vedantpathak2020-hue/Pascal/README.md

# Pascal
A repo for pascal (mazesolver v3)
