vedantpathak2020-hue/Pascal/pascalV0.1.pdf

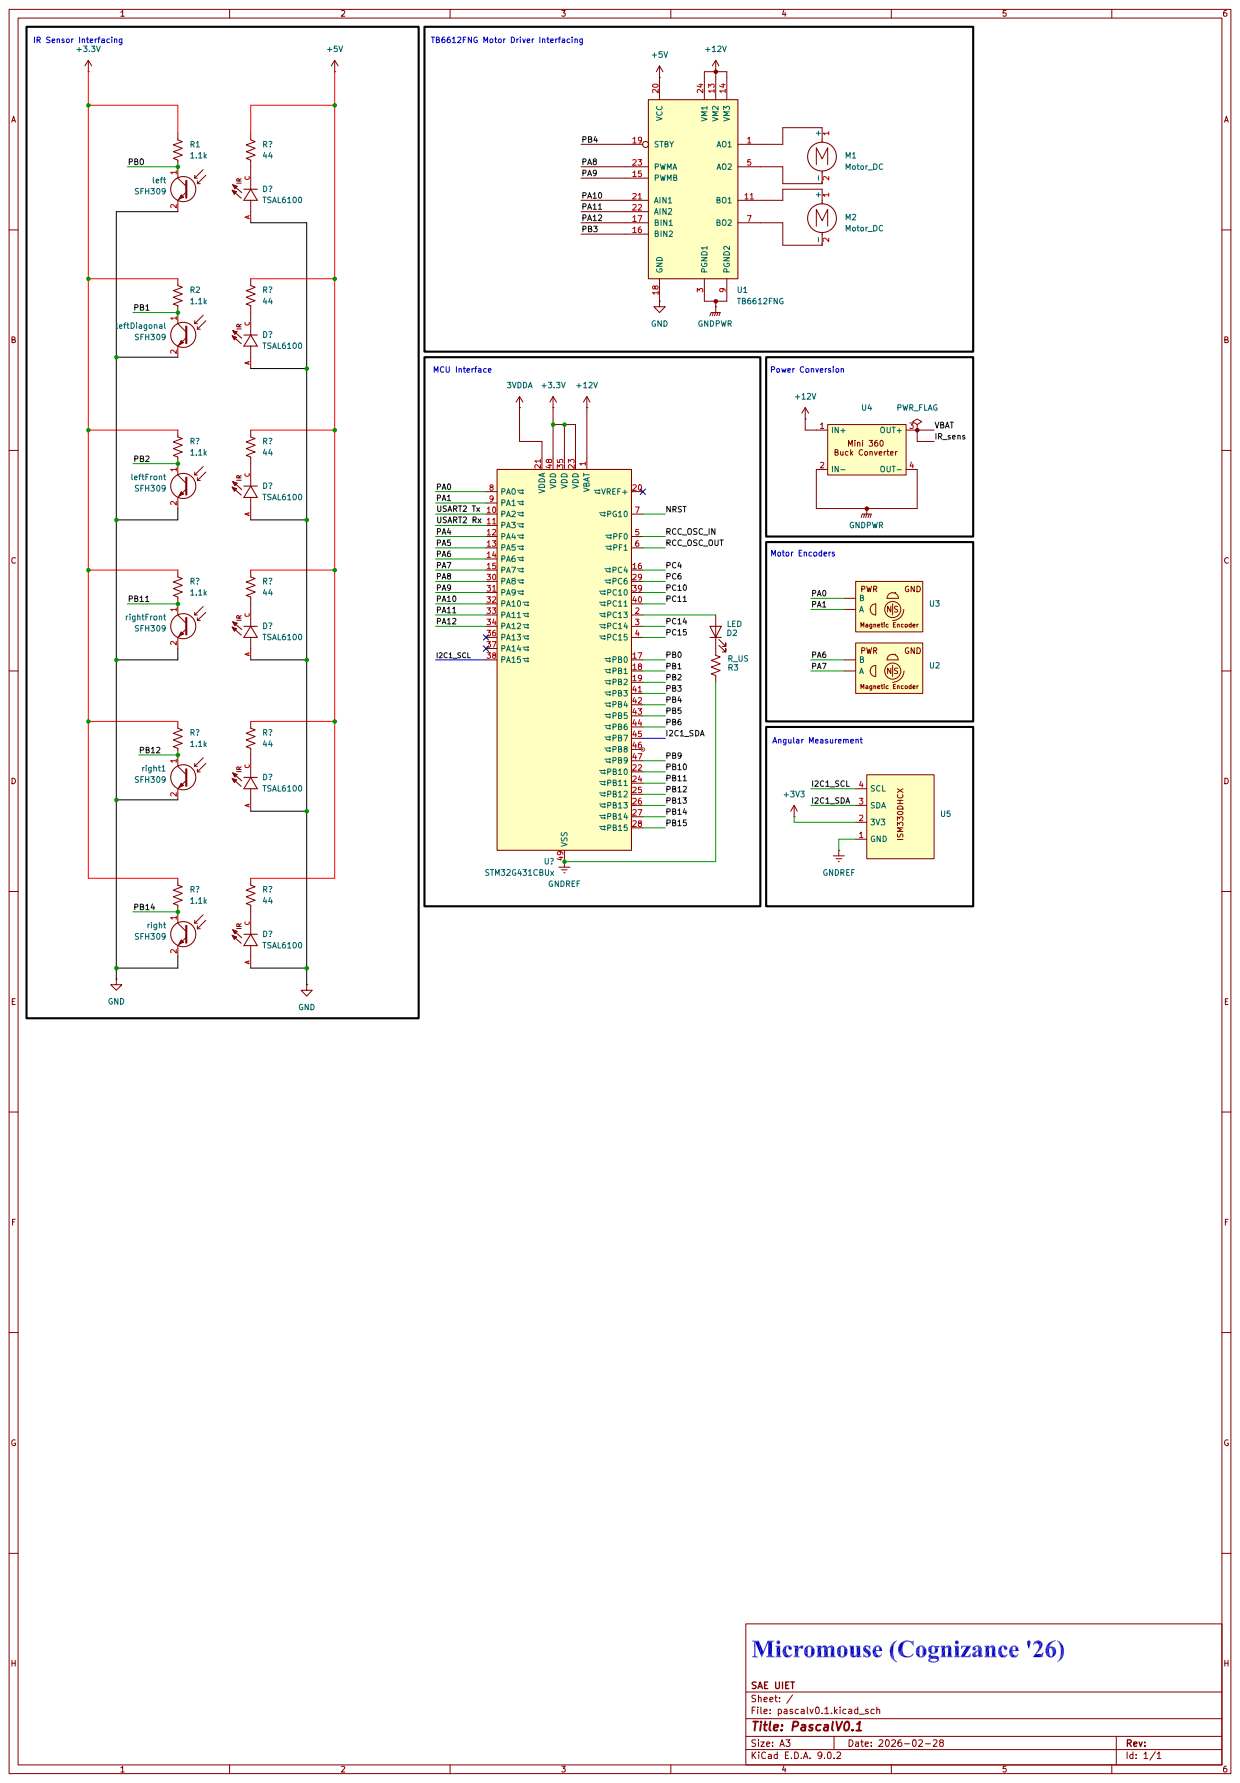
[picture p5: page 1]
