vedantpathak2020-hue/Pascal/pascalV0.1/Core/Src/main.c

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
/* Includes ------------------------------------------------------------------*/
#include "main.h"

/* USER CODE BEGIN Includes */

#include <stdio.h>
#include <stdlib.h>
#include <stdbool.h>
#include <string.h>

/* USER CODE END Includes */

/* USER CODE BEGIN PTD */
ADC_HandleTypeDef hadc1;
/* USER CODE END PTD */

/* USER CODE BEGIN PD */
uint16_t adc_pb0;
uint16_t adc_pb1;
uint16_t adc_pa4;
uint16_t adc_pb11;
uint16_t adc_pb12;
uint16_t adc_pb14;
uint16_t min =0;
uint16_t max =4096;
char buffer[140];

/* USER CODE END PD */

ADC_HandleTypeDef hadc1;

I2C_HandleTypeDef hi2c1;

TIM_HandleTypeDef htim1;
TIM_HandleTypeDef htim2;
TIM_HandleTypeDef htim3;
TIM_HandleTypeDef htim6;

UART_HandleTypeDef huart2;

void SystemClock_Config(void);
static void MX_GPIO_Init(void);
static void MX_ADC1_Init(void);
static void MX_I2C1_Init(void);
static void MX_TIM1_Init(void);
static void MX_TIM2_Init(void);
static void MX_TIM3_Init(void);
static void MX_USART2_UART_Init(void);
static void MX_TIM6_Init(void);
/* USER CODE BEGIN PFP */
uint16_t read_adc1_channel(uint32_t channel);
uint16_t read_adc2_channel(uint32_t channel);
/* USER CODE END PFP */

/**
  * @brief  The application entry point.
  * @retval int
  */
int main(void)
{

  /* MCU Configuration--------------------------------------------------------*/

  /* Reset of all peripherals, Initializes the Flash interface and the Systick. */
  HAL_Init();

  /* Configure the system clock */
  SystemClock_Config();

  /* Initialize all configured peripherals */
  MX_GPIO_Init();
  MX_ADC1_Init();
  MX_I2C1_Init();
  MX_TIM1_Init();
  MX_TIM2_Init();
  MX_TIM3_Init();
  MX_USART2_UART_Init();
  MX_TIM6_Init();
  /* Infinite loop */
  /* USER CODE BEGIN WHILE */
  while (1)
  {

	  adc_pb0  = read_adc1_channel(ADC_CHANNEL_15);
	  adc_pb1  = read_adc1_channel(ADC_CHANNEL_12);
	  adc_pa4  = read_adc2_channel(ADC_CHANNEL_17);
	  adc_pb11 = read_adc1_channel(ADC_CHANNEL_14);
	  adc_pb12 = read_adc1_channel(ADC_CHANNEL_11);
	  adc_pb14 = read_adc1_channel(ADC_CHANNEL_5);

	  sprintf(buffer,
	          "min:%4u PB0:%4u PB1:%4u PB2:%4u PB11:%4u PB12:%4u PB14:%4u max:%4u\r\n",
			  min,
	          adc_pb0,
	          adc_pb1,
	          adc_pa4,
	          adc_pb11,
	          adc_pb12,
	          adc_pb14,
			  max);

	  HAL_UART_Transmit(&huart2,
	                    (uint8_t*)buffer,
	                    strlen(buffer),
	                    HAL_MAX_DELAY);

	  HAL_Delay(10);
    /* USER CODE END WHILE */

    /* USER CODE BEGIN 3 */
  }
  /* USER CODE END 3 */
}

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
/* USER CODE BEGIN 4 */
int __io_putchar(int ch)
{
    HAL_UART_Transmit(&huart2, (uint8_t *)&ch, 1, HAL_MAX_DELAY);
    return ch;
}
/* USER CODE END 4 */
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
