vedantpathak2020-hue/Pascal/pascalV0.1/pascalV0.1.ioc

Mcu.UserName=STM32G431CBUx
PA0.GPIO_Label=Encoder1_1
PA0.Signal=S_TIM2_CH1
PA1.GPIO_Label=Encoder1_2
PA1.Signal=S_TIM2_CH2
PA10.GPIO_Label=IN1
PA10.Signal=GPIO_Output
PA11.GPIO_Label=IN2
PA11.Signal=GPIO_Output
PA12.GPIO_Label=IN3
PA12.Signal=GPIO_Output
PA13.Signal=SYS_JTMS-SWDIO
PA14.Signal=SYS_JTCK-SWCLK
PA15.Signal=I2C1_SCL
PA2.Signal=USART2_TX
PA3.GPIO_Label=LeftForwardIR
PA3.Signal=ADC1_IN4
PA6.GPIO_Label=Encoder2_1
PA6.Signal=S_TIM3_CH1
PA7.GPIO_Label=Encoder2_2
PA7.Signal=S_TIM3_CH2
PA8.GPIO_Label=PWMA
PA8.Signal=S_TIM1_CH1
PA9.GPIO_Label=PWMB
PA9.Signal=S_TIM1_CH2
PB0.GPIO_Label=left_IR
PB0.Signal=ADC1_IN15
PB1.GPIO_Label=leftDiagonal_IR
PB1.Signal=SharedAnalog_PB1
PB10.GPIO_Label=rightDiagonal OUT
PB10.Signal=GPIO_Output
PB11.GPIO_Label=rightForward_IR
PB11.Signal=SharedAnalog_PB11
PB12.GPIO_Label=rightDiagonal_IR
PB12.Signal=ADC1_IN11
PB13.GPIO_Label=RightForwardlOUT
PB13.Signal=GPIO_Output
PB14.GPIO_Label=right_IR
PB14.Signal=ADC1_IN5
PB15.GPIO_Label=RightIROUT
PB15.Signal=GPIO_Output
PB2.GPIO_Label=LeftIROUT
PB2.Signal=GPIO_Output
PB3.GPIO_Label=IN4
PB3.Signal=GPIO_Output
PB4.GPIO_Label=STBY
PB4.Signal=GPIO_Output
PB5.GPIO_Label=leftForwardIR
PB5.Signal=GPIO_Output
PB6.GPIO_Label=LeftDiagonalIROUT
PB6.Signal=GPIO_Output
PB7.Signal=I2C1_SDA
PF0-OSC_IN.Signal=RCC_OSC_IN
PF1-OSC_OUT.Signal=RCC_OSC_OUT
