vedantpathak2020-hue/Pascal/(notices)

Notices in the files:
pascalV0.1/Core/Src/main.c:
Copyright (c) 2026 STMicroelectronics.
All rights reserved.
This software is licensed under terms that can be found in the LICENSE file
